nromanel/ESPixelPOPs/preview.png

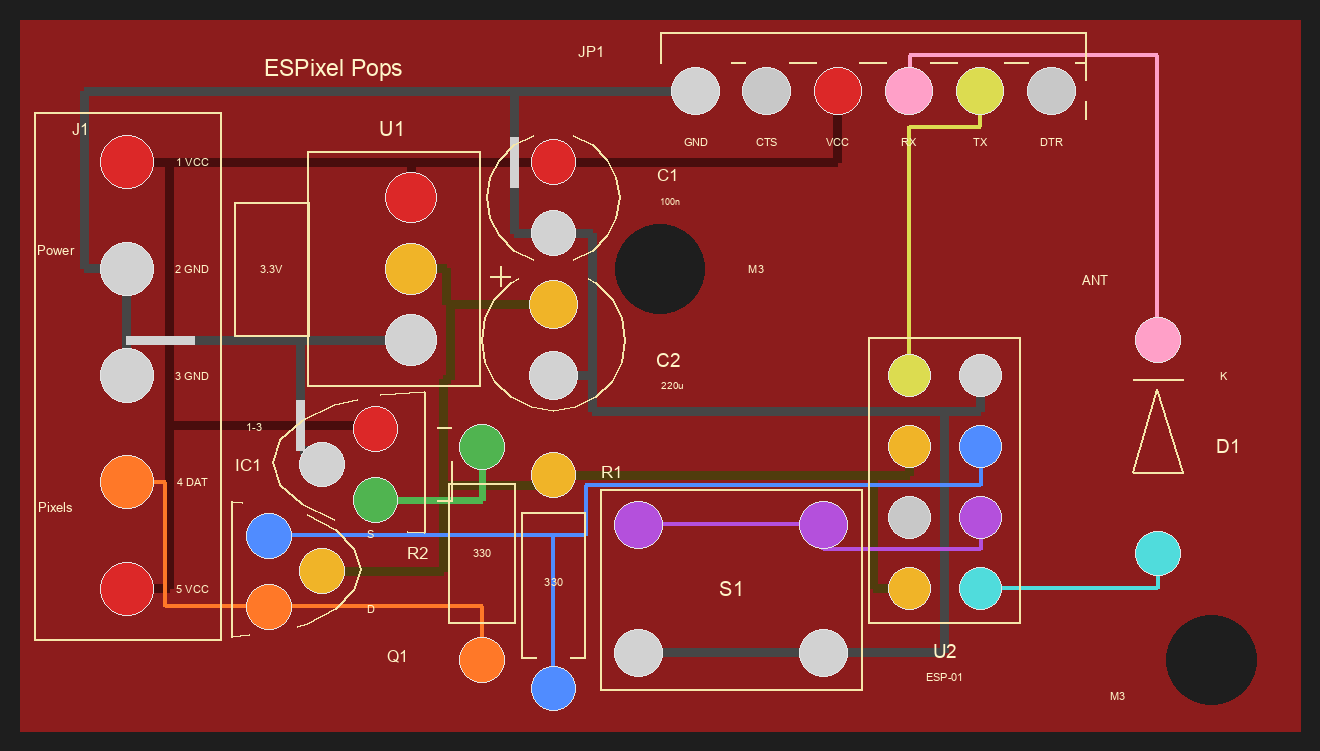
preview.png
