nromanel/ESPixelPOPs/ESPixelPop-Digikey.csv

Country of Origin may be different at time of shipment.
The HTSUS and ECCN information shown is for informational purposes only and is not a representation or warranty as to the accuracy or reliability of these classifications. All information is provided "as is" and is subject to change without notice. Any use made of the information provided is without recourse to Digi-Key and at the user's risk.
Index | Manufacturer Part Number | Manufacturer Name | Description | Lead Time | Availability | Stock Status | Attrition % | Requested Quantity 1 | Pack Quantity 1 | Pack Type 1 | Digi-Key Part Number 1 | Unit Price 1 | Extended Price 1 | Minimum Order Quantity 1 | Customer Reference | Requested Part Number | Lead Weeks | Datasheet | Reference Designator | US Import Tariff | Note | Part Status | RoHS Status | REACH Status | Moisture Sensitivity Level (MSL) | ECCN | HTSUS | Country of Origin | Environmental Information | Original Part numbers | Unit of Measure | Image | Product Notes
1 | LD1117V33C | STMicroelectronics | IC REG LINEAR 3.3V 800MA TO220 |  | 2,166 | In Stock |  | 1 | 1 | Tube | 497-1492-5-ND | 1.14000 | $1.14 | 1 | U1 | 497-1492-5-ND | 30 | https://www.st.com/content/ccc/resource/technical/document/datasheet/99/3b/7d/91/91/51/4b/be/CD00000544.pdf/files/CD00000544.pdf/jcr:content/translations/en.C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 |  | May apply on shipments to the U.S. |  | Active | ROHS3 Compliant | REACH Unaffected | 1 (Unlimited) | EAR99 | 8542.39.0090 | China |  | 497-1491-5-ND | Each | https://mm.digikey.com/Volume0/opasdata/d220001/medias/images/2660/497%7ETO220-3TO220AB%7E%7E3.JPG
2 | L78L05ACZ | STMicroelectronics | IC REG LINEAR 5V 100MA TO92-3 |  | 9,821 | In Stock |  | 1 | 1 | Bulk | 497-2952-ND | 0.27000 | $0.27 | 1 | IC1 | 497-2952-ND | 30 | https://www.st.com/resource/en/datasheet/l78l.pdf |  | May apply on shipments to the U.S. |  | Active | ROHS3 Compliant | REACH Unaffected | 1 (Unlimited) | EAR99 | 8542.39.0090 | Singapore |  | LM78L05ACZNS/NOPB-ND | Each | https://mm.digikey.com/Volume0/opasdata/d220001/medias/images/376/TO-92-3%28StandardBody%29%2CTO-226_straightlead.jpg
3 | 2N7000 | onsemi | MOSFET TO92 N 60V 0.2A 5OHM 150C |  | 127,650 | In Stock |  | 1 | 1 | Bulk | 2N7000FS-ND | 0.65000 | $0.65 | 1 | Q1 | 2N7000FS-ND | 22 | https://www.onsemi.com/pub/Collateral/NDS7002A-D.PDF |  | May apply on shipments to the U.S. |  | Active | ROHS3 Compliant | REACH Unaffected | Not Applicable | EAR99 | 8541.21.0095 | China | https://www.onsemi.com/site/pdf/RoHS-statement.pdf|https://www.onsemi.com/PowerSolutions/MaterialComposition.do?export=pdf&opnId=2N7000 | 2N7000FS-ND | Each | https://mm.digikey.com/Volume0/opasdata/d220001/medias/images/6157/488%7EMKT-ZA03D%7E%7E3.jpg
4 | 1N4148 | onsemi | DIODE STANDARD 100V 200MA DO35 |  | 624,438 | In Stock |  | 1 | 1 | Bulk | 1N4148FS-ND | 0.10000 | $0.10 | 1 | D1 | 1N4148FS-ND | 62 | https://www.onsemi.com/pub/Collateral/1N914-D.PDF |  | May apply on shipments to the U.S. |  | Active | ROHS3 Compliant | REACH Unaffected | Not Applicable | EAR99 | 8541.10.0070 | China | https://www.onsemi.com/site/pdf/RoHS-statement.pdf|https://www.onsemi.com/PowerSolutions/MaterialComposition.do?export=pdf&opnId=1N4148 | 1N4148FS-ND | Each | https://mm.digikey.com/Volume0/opasdata/d220001/medias/images/649/1N5229BFS.jpg
5 | CF14JT330R | Stackpole Electronics Inc | RES 330 OHM 5% 1/4W AXIAL |  | 285,372 | In Stock |  | 2 | 2 | Cut Tape (CT) | CF14JT330RCT-ND | 0.10000 | $0.20 | 1 | R1,R2 | CF14JT330RCT-ND | 17 | https://www.seielect.com/catalog/SEI-CF_CFM.pdf |  | May apply on shipments to the U.S. |  | Active | ROHS3 Compliant | REACH Unaffected | Not Applicable | EAR99 | 8533.10.0065 | China | https://www.seielect.com/catalog/SEI-RoHS_Compliance_Status.pdf|https://www.seielect.com/catalog/reach.pdf|https://www.seielect.com/catalog/sei-coc%20prop%2065.pdf | CF14JT330RCT-ND | Each | https://mm.digikey.com/Volume0/opasdata/d220001/derivates/6/002/630/016/CF%20330_web%28640x640%29.jpg
6 | K104K10X7RF53L2 | Vishay Beyschlag/Draloric/BC Components | CAP CER 0.1UF 50V X7R RADIAL |  | 23,456 | In Stock |  | 1 | 1 | Bulk | BC5137-ND | 0.26000 | $0.26 | 1 | C1 | BC5137-ND | 18 | https://www.vishay.com/docs/45171/kseries.pdf |  | May apply on shipments to the U.S. |  | Active | ROHS3 Compliant | REACH Unaffected | Not Applicable | EAR99 | 8532.24.0060 | China |  | 399-4264-ND | Each | https://mm.digikey.com/Volume0/opasdata/d220001/medias/images/4847/56_K102K15X7RF5TL2.jpg
7 | 1825910-6 | TE Connectivity ALCOSWITCH Switches | SWITCH TACTILE SPST-NO 0.05A 24V |  | 95,072 | In Stock |  | 1 | 1 | Bulk | 450-1650-ND | 0.13000 | $0.13 | 1 | S1 | 450-1650-ND | 15 | https://www.te.com/commerce/DocumentDelivery/DDEController?Action=srchrtrv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 |  | May apply on shipments to the U.S. |  | Active | ROHS3 Compliant | REACH Unaffected | 1 (Unlimited) | EAR99 | 8536.50.9031 | China | https://www.te.com/commerce/alt/SinglePartSearch.do?PN=FSM4JH&dest=stmt | 450-1650-ND | Each | https://mm.digikey.com/Volume0/opasdata/d220001/medias/images/4845/17_FSM4JH.jpg
8 | SSK01-MPH-254-A6 | Same Sky (Formerly CUI Devices) | 2.54MM MALE HEADER 1X6PIN, STRAI |  | 8,505 | In Stock |  | 1 | 1 | Bag | 2223-SSK01-MPH-254-A6-ND | 0.13000 | $0.13 | 1 | JP1 | 2223-SSK01-MPH-254-A6-ND | 9 | https://www.sameskydevices.com/product/resource/digikeypdf/ssk01-mph-254.pdf |  | May apply on shipments to the U.S. |  | Active | ROHS3 Compliant |  | 1 (Unlimited) | EAR99 | 8536.69.4040 | China |  | 2223-SSK01-MPH-254-A6-ND | Each | https://mm.digikey.com/Volume0/opasdata/d220001/derivates/6/003/250/902/MFG_SSK01-MPH-254-A6_web%28640x640%29.jpg
9 | SSK04-FPH-254-B4 | Same Sky (Formerly CUI Devices) | 2.54MM FEMALE HEADER 2X4PIN , ST |  | 2,517 | In Stock |  | 1 | 1 | Tray | 2223-SSK04-FPH-254-B4-ND | 0.36000 | $0.36 | 1 | U2 | 2223-SSK04-FPH-254-B4-ND | 9 | https://www.sameskydevices.com/product/resource/digikeypdf/ssk04-fph-254.pdf |  | May apply on shipments to the U.S. |  | Active | ROHS3 Compliant |  | 1 (Unlimited) | EAR99 | 8536.69.4040 | China |  | 2223-SSK04-FPH-254-B4-ND | Each | https://mm.digikey.com/Volume0/opasdata/d220001/derivates/6/003/250/904/MFG_SSK04-FPH-254-B4_web%28640x640%29.jpg
10 | ESH227M016AE3AA | KEMET | CAP ALUM 220UF 20% 16V RADIAL TH |  | 6,926 | In Stock |  | 1 | 1 | Bulk | 399-6566-ND | 0.28000 | $0.28 | 1 | C2 | 399-6566-ND | 24 | https://yageogroup.com/content/datasheet/asset/file/KEM_A4005_ESH |  | May apply on shipments to the U.S. |  | Active | ROHS3 Compliant | REACH Unaffected | Not Applicable | EAR99 | 8532.22.0020 | China |  | 399-6566-ND | Each | https://mm.digikey.com/Volume0/opasdata/d220001/medias/images/631/ESH476M035AE3AA.JPG
11 | EBWA-05-B | Adam Tech | EURO BLOCK 5P |  | 1,244 | In Stock |  | 1 | 1 | Box | 2057-EBWA-05-B-ND | 1.25000 | $1.25 | 1 | J1 | 2057-EBWA-05-B-ND | 18 | https://app.adam-tech.com/products/download/data_sheet/204240/ebwa-xx-b-data-sheet.pdf |  | May apply on shipments to the U.S. |  | Active | ROHS3 Compliant | REACH Unaffected | 1 (Unlimited) | EAR99 | 8536.90.4000 | China |  | 2057-EBWA-05-B-ND | Each | https://mm.digikey.com/Volume0/opasdata/d220001/medias/images/329/EBWA-05-B.jpg
