nromanel/ESPixelPOPs/ESPixel_PopsSchematic.pdf

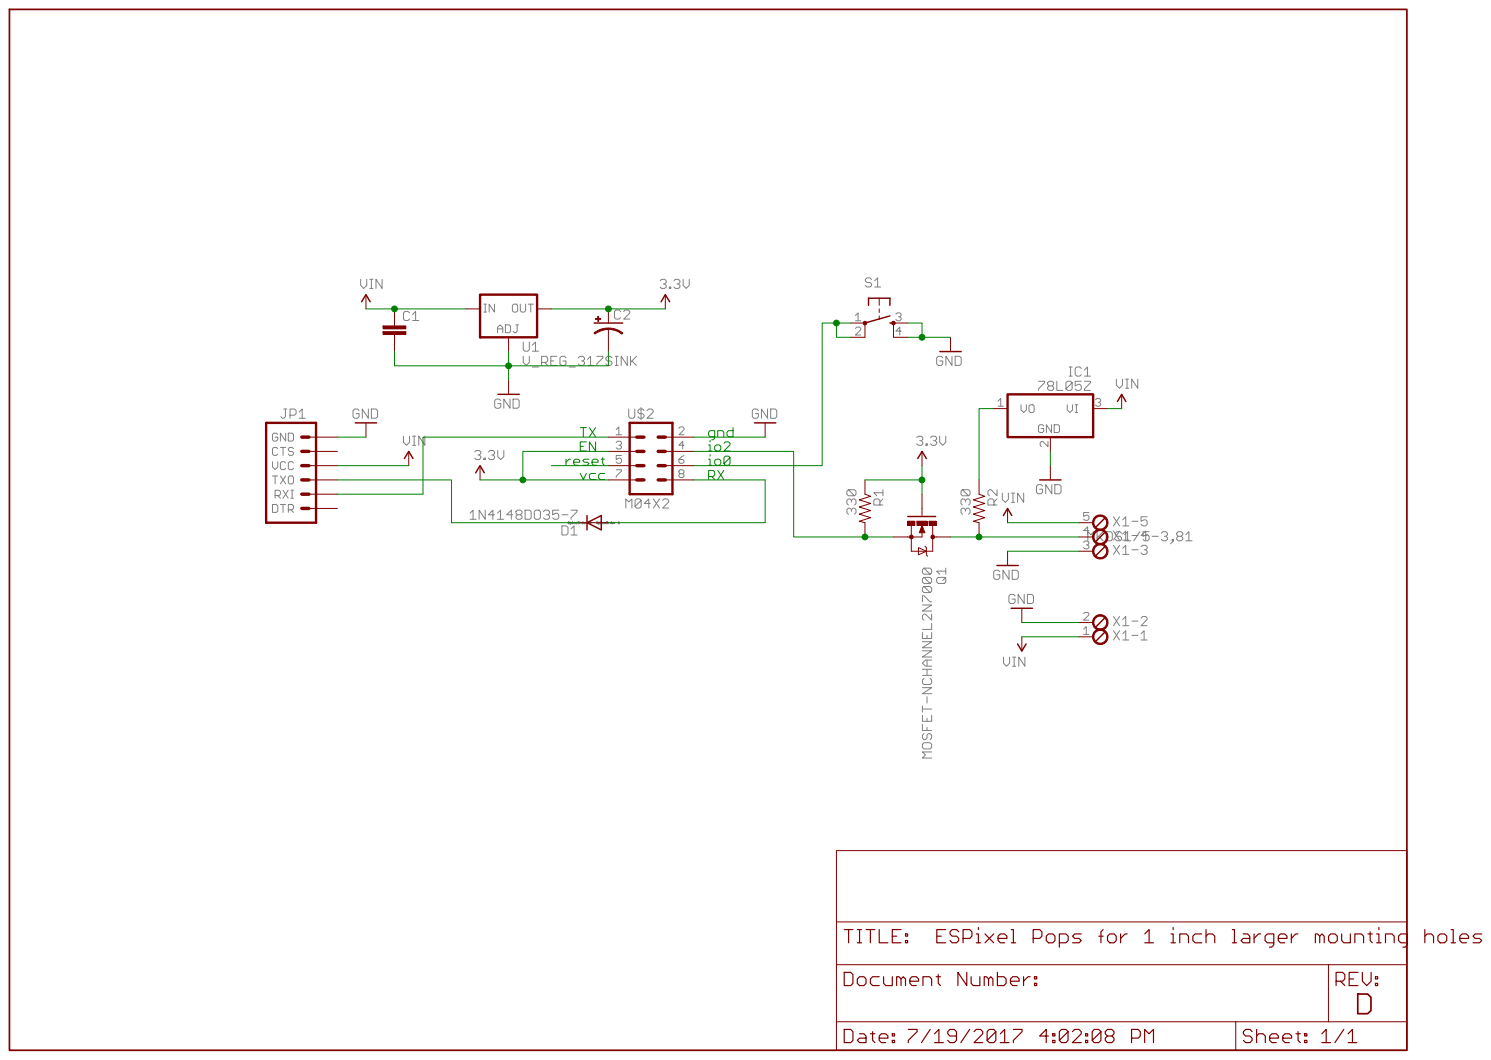
[picture p14: page 1]
