nromanel/ESPixelPOPs/ESPixelPOPs.kicad_pcb

## KiCad design ESPixelPOPs.kicad_pcb (2026-10-12)

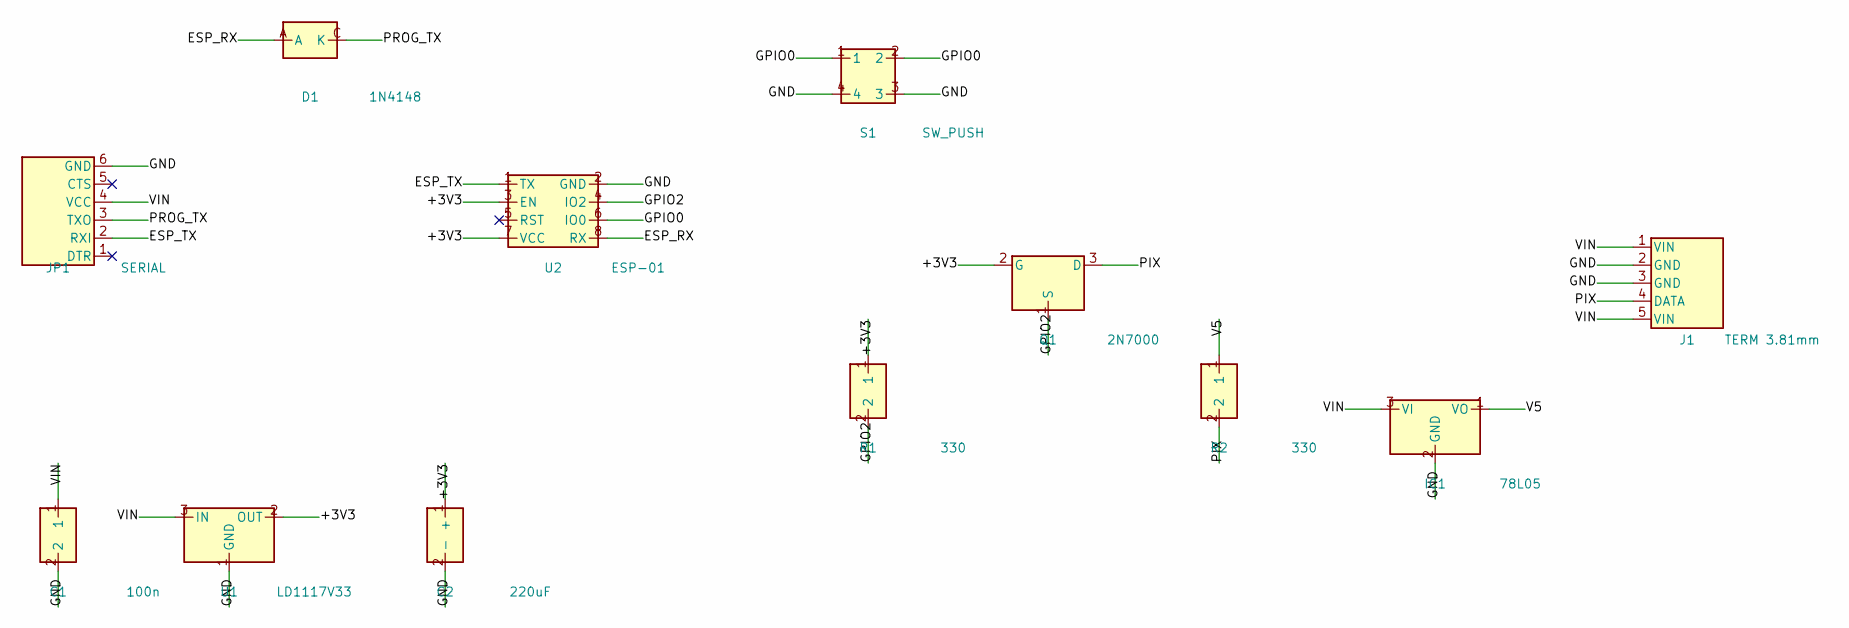
[picture p15: schematic ESPixelPOPs.kicad_sch, ESPixel Pops]

Parts:
C1: 100n; C_Disc_D5.0mm_W2.5mm_P2.54mm
C2: 220uF; CP_Radial_D5.0mm_P2.54mm
D1: 1N4148; D_DO-35_SOD27_P7.62mm_Vertical
IC1: 78L05; TO-92_Inline
J1: TERM 3.81mm; TerminalBlock_1x05_P3.81mm
JP1: SERIAL; PinHeader_1x06_P2.54mm_Vertical
Q1: 2N7000; TO-92_Inline
R1, R2: 330; R_Axial_DIN0207_L6.3mm_D2.5mm_P7.62mm
S1: SW_PUSH; SW_PUSH_6mm
U1: LD1117V33; TO-220-3_Vertical
U2: ESP-01; PinSocket_2x04_P2.54mm_Vertical

Connections:
+3V3: C2.1 (+), Q1.2 (G), R1.1, U1.2 (OUT), U2.3 (EN), U2.7 (VCC)
ESP_RX: D1.A, U2.8 (RX)
ESP_TX: JP1.2 (RXI), U2.1 (TX)
GND: C1.2, C2.2 (-), IC1.2 (GND), J1.2 (GND), J1.3 (GND), JP1.6 (GND), S1.3, S1.4, U1.1 (GND), U2.2 (GND)
GPIO0: S1.1, S1.2, U2.6 (IO0)
GPIO2: Q1.1 (S), R1.2, U2.4 (IO2)
PIX: J1.4 (DATA), Q1.3 (D), R2.2
PROG_TX: D1.C (K), JP1.3 (TXO)
V5: IC1.1 (VO), R2.1
VIN: C1.1, IC1.3 (VI), J1.1 (VIN), J1.5 (VIN), JP1.4 (VCC), U1.3 (IN)

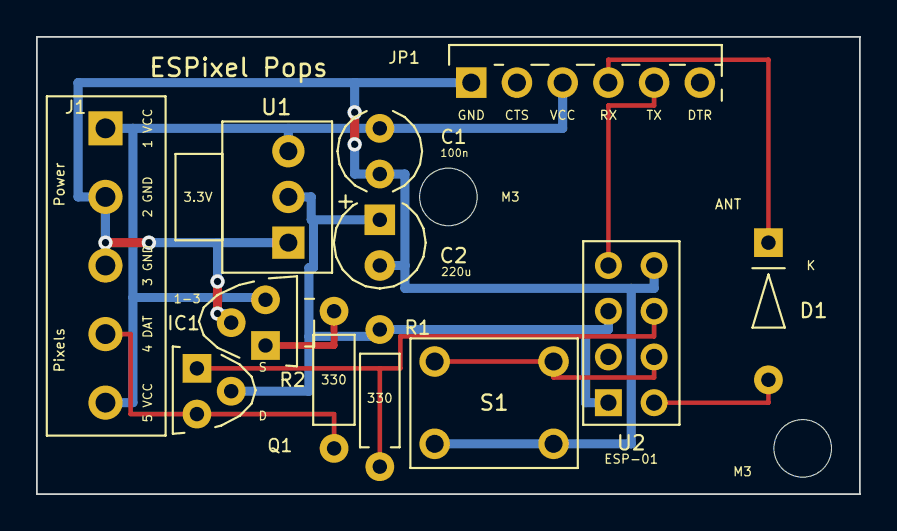
[picture p16: board ESPixelPOPs.kicad_pcb from above]

Board: 2 copper layers, 45.7 x 25.4 mm, 12 parts (0 on the bottom side), 10 nets.
