nromanel/ESPixelPOPs/(commit log)

2026-10-12 Recreate the ESPixel Pops board from the original materials.
    This is an attempted re-creation, not the author's released design files.
    [ESPixelPOPs.kicad_pcb, ESPixelPOPs.kicad_sch, bom.csv]
2026-10-12 Add Original materials from Wiki and Wayback Machine
2026-10-12 Add Digikey part list As of Oct 2026
    [ESPixelPop-Digikey.csv, bom.csv]
